lucaspferro/TCC_Unisal/README.md

# Dispositivo MHR Monitoramento Hidrico Residencial

## TCC_Unisal

## Installation

Install with pip:

```
$ pip install -r requirements.txt
```
## Run Flask
### Run flask for develop
```
$ python webapp/run.py
```
In flask, Default port is `5000`

Swagger document page:  `http://127.0.0.1:5000/api`

## Another way to run the application 
### In linux bash 
```
  export FLASK_APP= <File.py>
  export FLASK_DEBUG=1
  flask run -h <use your ip>
```
