lucaspferro/TCC_Unisal/(commit log)

2023-10-31 Calculo de resistência em tempo real
    Calculo da resistência utilizando a lei de ohm
2023-11-03 add arduino master e slave
2023-11-07 arduino master
2023-11-08 Update and rename arduino_slave.ino to arduino_slave_node.ino
